corgiolu-labs/esp32-lifepo4-battery-tester/firmware/LiFePO4_Tester/web_icons.h

#pragma once
// Generato da tools/make_icons.py - NON modificare a mano
#include <pgmspace.h>

const uint8_t ICON_192_PNG[757] PROGMEM = {
  0x89,0x50,0x4E,0x47,0x0D,0x0A,0x1A,0x0A,0x00,0x00,0x00,0x0D,0x49,0x48,0x44,0x52,0x00,0x00,0x00,0xC0,0x00,0x00,0x00,0xC0,
  0x08,0x06,0x00,0x00,0x00,0x52,0xDC,0x6C,0x07,0x00,0x00,0x02,0xBC,0x49,0x44,0x41,0x54,0x78,0xDA,0xED,0xDC,0xB1,0xAD,0xC2,
  0x40,0x14,0x05,0x51,0x97,0x40,0x48,0x09,0x14,0x40,0xB3,0xD4,0x45,0x23,0x24,0x24,0x24,0x20,0x08,0xC9,0x40,0xC2,0x66,0x77,
  0x8E,0xA5,0x89,0x91,0xAE,0xDF,0x09,0x90,0xFE,0x67,0x59,0x36,0x78,0x76,0xFB,0xC3,0x5D,0x7A,0x6F,0x99,0xF1,0xF1,0x62,0x95,
  0x44,0xE1,0xE5,0x29,0x07,0xC1,0x8B,0x52,0x16,0x83,0x17,0xA3,0x24,0x02,0x2F,0x43,0x49,0x08,0xC6,0x57,0x16,0x82,0xC1,0x95,
  0x45,0x60,0x68,0x65,0x11,0x18,0x58,0x59,0x04,0x86,0x55,0x16,0x81,0x41,0x95,0x45,0x60,0x48,0x65,0x11,0x18,0x50,0x59,0x04,
  0x86,0x53,0x1A,0x81,0xD1,0x94,0x05,0x60,0x30,0xA5,0x11,0x18,0x4B,0x59,0x00,0x86,0x52,0x16,0x81,0x81,0x94,0x46,0x60,0x1C,
  0x01,0x20,0x15,0x01,0x18,0x46,0x69,0x04,0x46,0x51,0x16,0x80,0x41,0x94,0x46,0x60,0x0C,0x01,0x20,0x01,0x20,0x01,0x20,0x75,
  0x00,0x18,0x42,0x69,0x04,0x46,0x10,0x00,0x12,0x00,0x12,0x00,0x12,0x00,0x12,0x00,0x12,0x00,0x12,0x00,0x12,0x00,0x12,0x00,
  0x12,0x00,0x12,0x00,0x12,0x00,0x12,0x00,0x12,0x00,0x12,0x00,0x12,0x00,0x12,0x00,0x12,0x00,0x12,0x00,0x12,0x00,0x12,0x00,
  0x12,0x00,0x12,0x00,0x12,0x00,0x12,0x00,0x12,0x00,0x12,0x00,0xD2,0xFC,0x00,0x2E,0xD7,0x9B,0x22,0x01,0x00,0x00,0x00,0x00,
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
  0x00,0x08,0x00,0x00,0x01,0x80,0x00,0x48,0x06,0x80,0xF9,0x02,0xF6,0x17,0x02,0xC0,0x03,0x02,0xB0,0xBF,0x10,0x00,0x1E,0x10,
  0x80,0xFD,0x85,0x00,0xF0,0x80,0x00,0xEC,0x2F,0x04,0x80,0x07,0x04,0x60,0x7F,0x21,0x00,0x3C,0x20,0x00,0xFB,0x0B,0x01,0xE0,
  0x01,0x01,0xD8,0x5F,0x08,0x00,0x0F,0x08,0xB0,0xBF,0xEC,0x2F,0x04,0x80,0x07,0x04,0xD8,0x5F,0xF6,0x17,0x02,0xC0,0x03,0x02,
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
};
