corgiolu-labs/esp32-lifepo4-battery-tester/(commit log)

2026-09-19 Tester per batterie LiFePO4 24V con ESP32: firmware, web-app, app Android
    - Firmware ESP32 D1 mini senza librerie esterne: shunt 100A/75mV letto da
    ADS1115 (o INA226), partitore di tensione, coulomb counting, test di
    capacita' con cutoff, rilevamento dello stacco del BMS, rele' di stacco
    carico, log CSV per test, storico e confronto tra batterie.
    - Web-app incorporata (italiano): monitor in tempo reale con grafico
    persistente di 6 ore, grafico di confronto tra test, tarature dall'app,
    aggiornamento firmware via Wi-Fi.
    - App Android (wrapper Kotlin) e documentazione hardware con schemi.
    - Strumenti: simulatore delle API, confronto CSV con matplotlib.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
2026-10-08 Restructure Android app, bilingual docs and firmware updates
    Replace the Gradle-based Android project with a plain build.ps1 + Java
    wrapper (self-updating, no Gradle), add the Italian hardware guide, rename
    the wiring diagrams, and include the pending firmware/web UI changes.
    [LiFePO4_Tester.ino, config.h, web_ui.h]
2026-10-08 Update 3bk1 charge result and clarify what flags the defect
